Iipal/teethless40/README.md

# TeethLess40

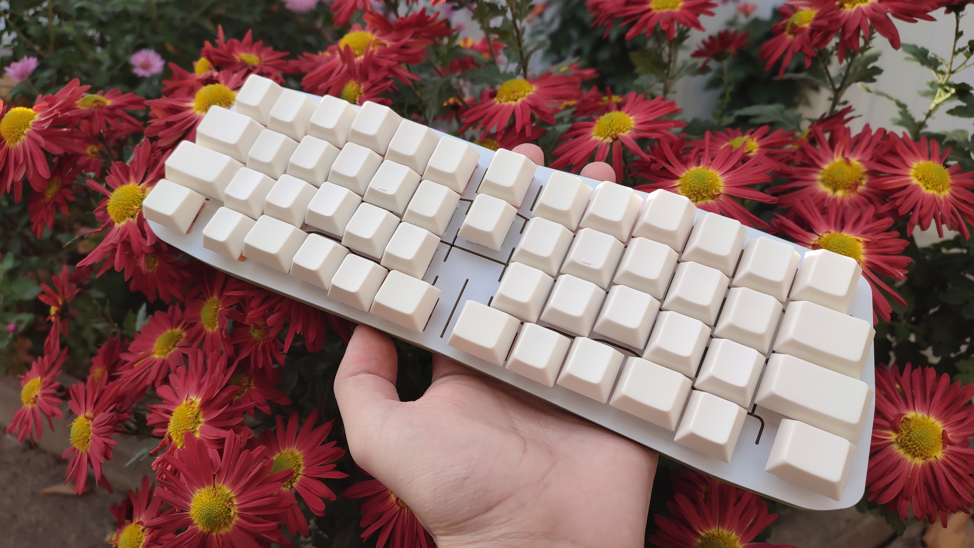
[picture p1: imgs/front.jpg]

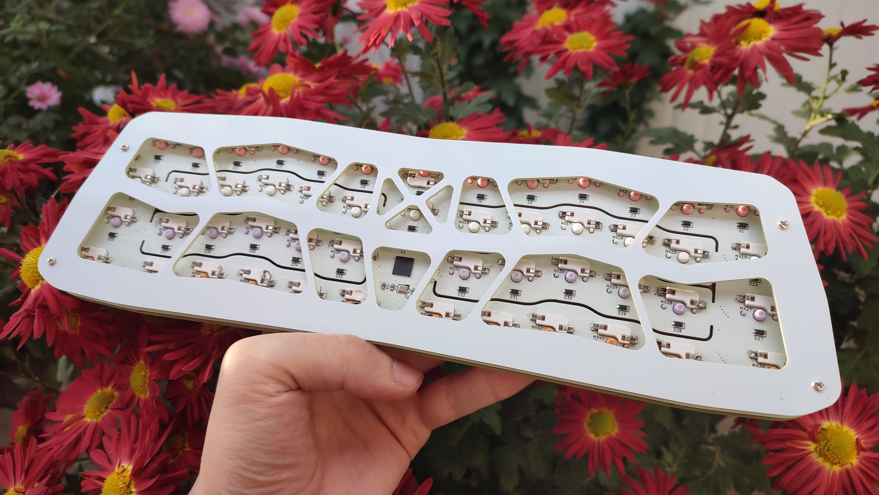
[picture p2: imgs/back.jpg]


# Layout

_40% Column-Staggered Symetrical Split-Layout_

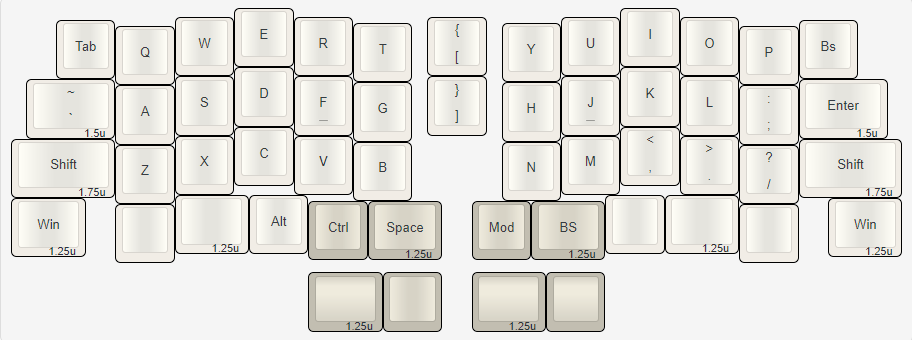
[picture p3: Layouts/imgs/v4.png]
