Iipal/teethless40/Cases/FR4/TL40_plateF_and_bottom.dxf

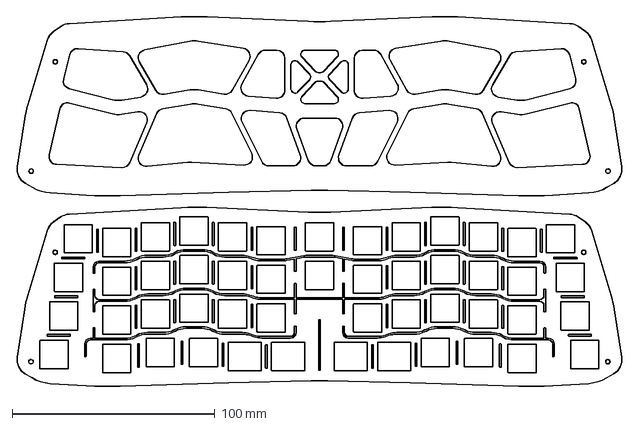
[picture p6: CAD file, 2022-11-02]
Cases/FR4/TL40_plateF_and_bottom.dxf
299.4 x 182.7 mm
