Iipal/teethless40/Cases/FR4/TL40_bottom.dxf

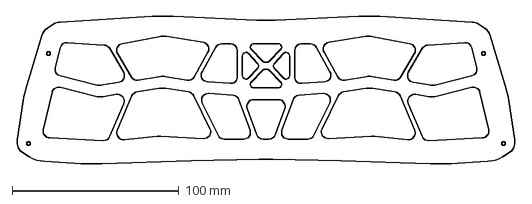
[picture p9: CAD file, 2022-11-02]
Cases/FR4/TL40_bottom.dxf
299.3 x 88.7 mm
