Iipal/teethless40/Cases/FR4/TL40_pcb.dxf

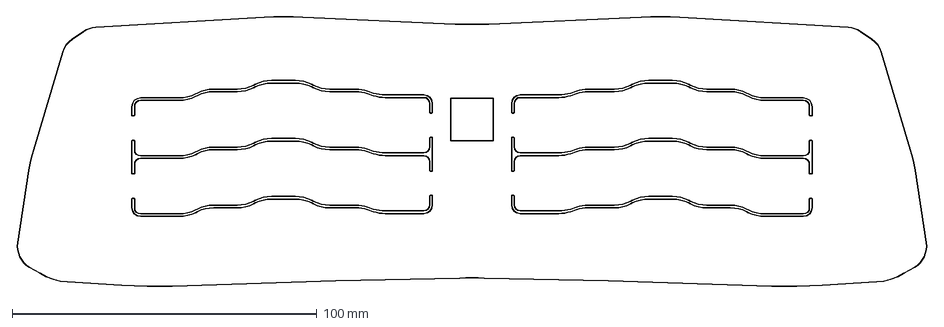
[picture p10: CAD file, 2022-11-02]
Cases/FR4/TL40_pcb.dxf
299.3 x 88.7 mm
