Iipal/teethless40/PCB/tl40_pcb.kicad_sch

## KiCad design PCB/tl40_pcb.kicad_sch (2022-11-02)

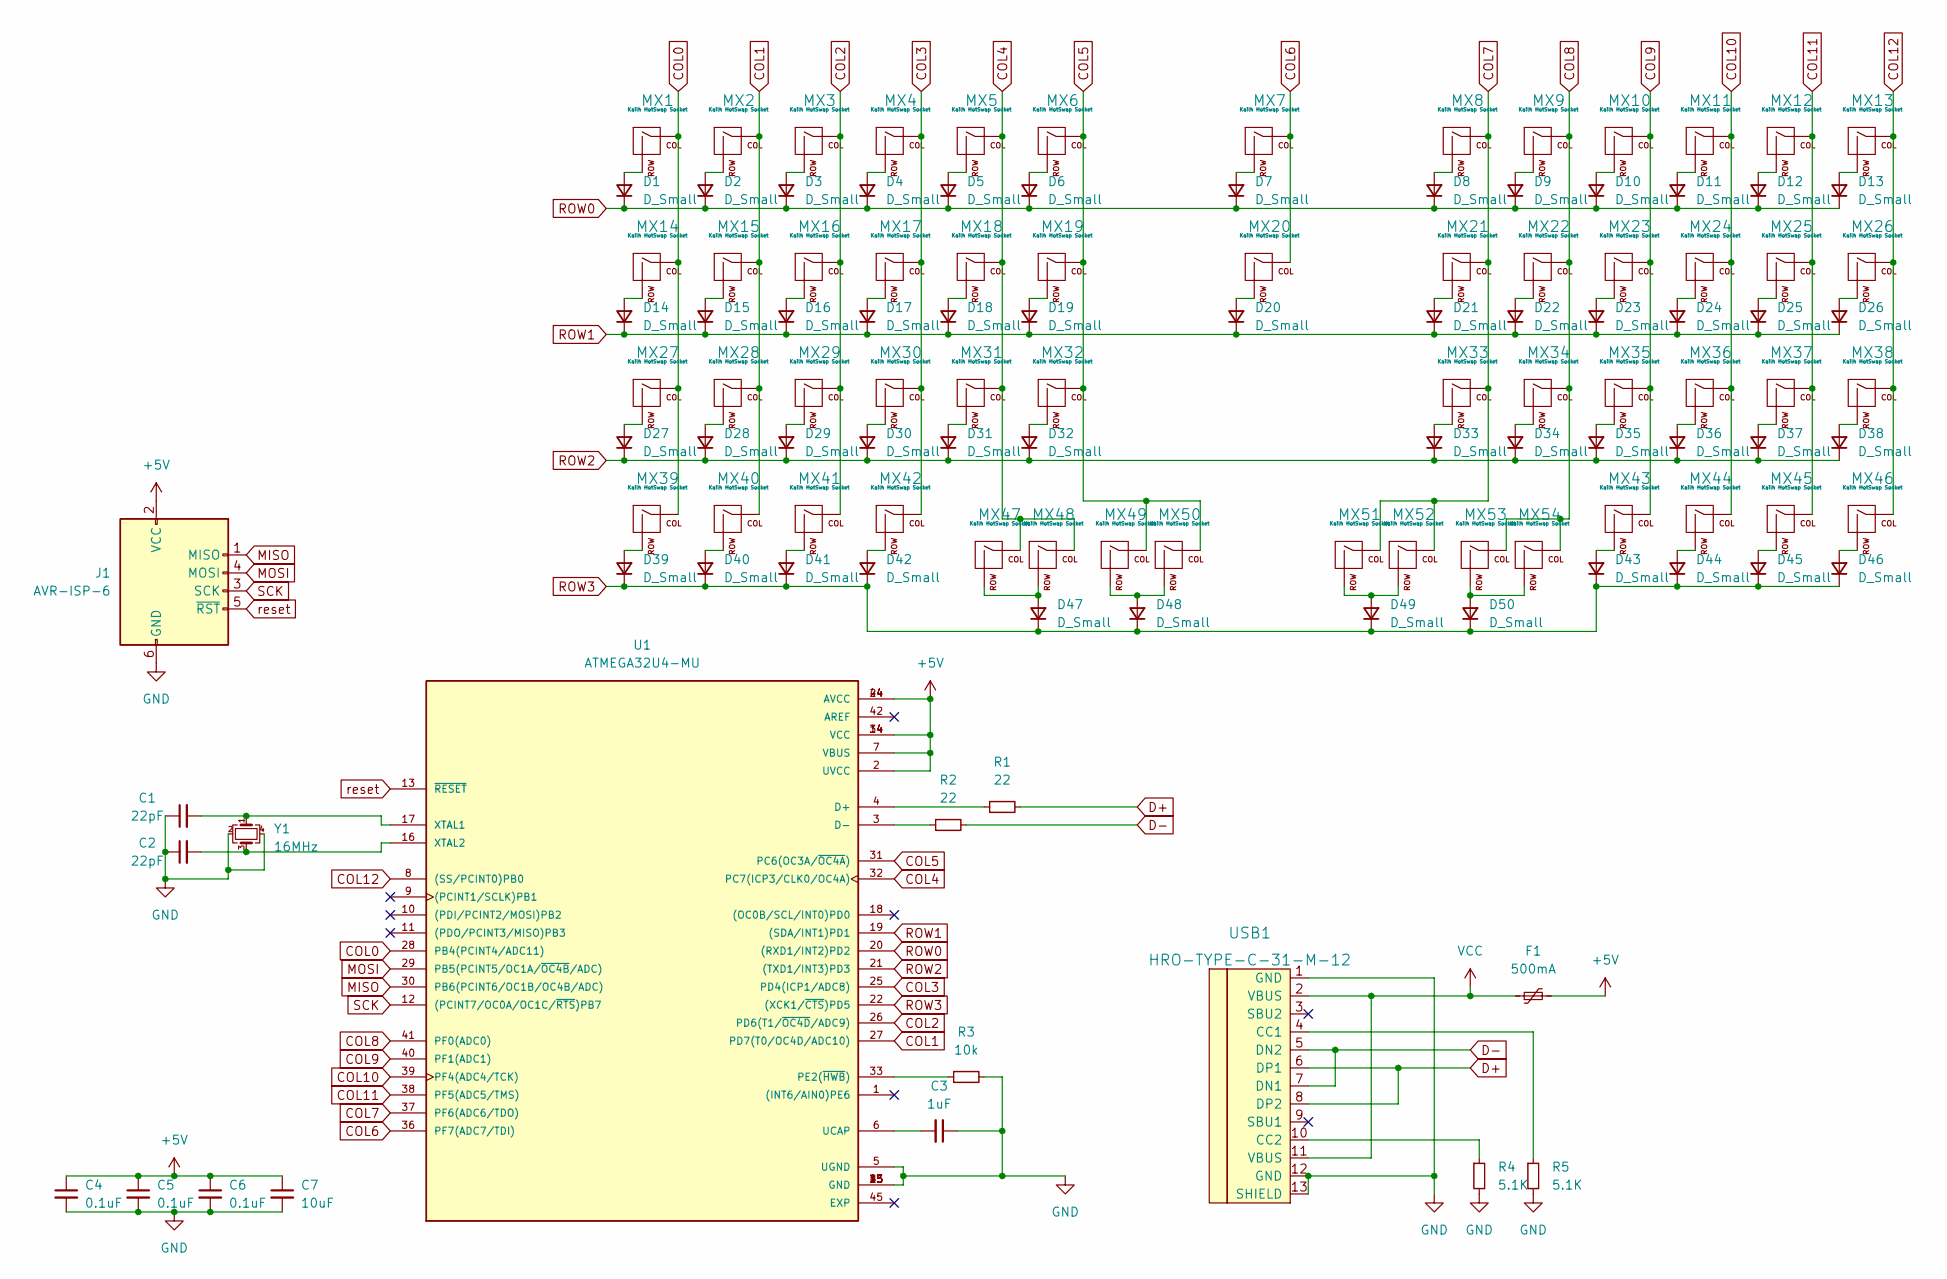
[picture p11: schematic tl40_pcb.kicad_sch]

Parts:
C1, C2: 22pF; C_0805_2012Metric; LCSC Part C472837
C3: 1uF; C_0805_2012Metric; LCSC Part C116352
C4, C5, C6: 0.1uF; C_0805_2012Metric; LCSC Part C38141
C7: 10uF; C_0805_2012Metric; LCSC Part C90545
D1, D2, D3, D4, D5, D6, D7, D8, D9, D10, D11, D12, D13, D14, D15, D16, D17, D18, D19, D20, D21, D22, D23, D24, D25, D26, D27, D28, D29, D30, D31, D32, D33, D34, D35, D36, D37, D38, D39, D40, D41, D42, D43, D44, D45, D46, D47, D48, D49, D50: D_Small; D_SOD-123; LCSC Part C77978
F1: 500mA; JK-nSMD050-24_F1206_; LCSC Part C369160
J1: AVR-ISP-6; AVR_ICSP_3x2; JLCPCB BOM False
MX1, MX2, MX3, MX4, MX5, MX6, MX7, MX8, MX9, MX10, MX11, MX12, MX13, MX15, MX16, MX17, MX18, MX19, MX20, MX21, MX22, MX23, MX24, MX25, MX28, MX29, MX30, MX31, MX32, MX33, MX34, MX35, MX36, MX37, MX40, MX42, MX43, MX45, MX47, MX50, MX51, MX54: Kailh HotSwap Socket; SW_MX_HS_1u; JLCPCB Part C5156480
MX14, MX26: Kailh HotSwap Socket; SW_MX_HS_1.5u; JLCPCB Part C5156480
MX27, MX38: Kailh HotSwap Socket; SW_MX_HS_1.75u; JLCPCB Part C5156480
MX39, MX41, MX44, MX46, MX48, MX49, MX52, MX53: Kailh HotSwap Socket; SW_MX_HS_1.25u; JLCPCB Part C5156480
R1, R2: 22; R_0805_2012Metric; LCSC Part C413152
R3: 10k; R_0805_2012Metric; LCSC Part C191101
R4, R5: 5.1K; R_0805_2012Metric; LCSC Part C413290
U1: ATMEGA32U4-MU; QFN50P700X700X100-45N; PARTREV E; LCSC Part C112161
USB1: HRO-TYPE-C-31-M-12; HRO-TYPE-C-31-M-12-Assembly; LCSC Part C165948
Y1: 16MHz; CRYSTAL-SMD_4P-L3.2-W2.5-BL; LCSC Part C258942

Connections:
+5V: C4.1, C5.1, C6.1, C7.1, F1.2, J1.2 (VCC), U1.2 (UVCC), U1.7 (VBUS), U1.14 (VCC), U1.24 (AVCC), U1.34 (VCC), U1.44 (AVCC)
COL0: MX1.1 (COL), MX14.1 (COL), MX27.1 (COL), MX39.1 (COL), U1.28 (PB4(PCINT4/ADC11))
COL1: MX2.1 (COL), MX15.1 (COL), MX28.1 (COL), MX40.1 (COL), U1.27 (PD7(T0/OC4D/ADC10))
COL2: MX3.1 (COL), MX16.1 (COL), MX29.1 (COL), MX41.1 (COL), U1.26 (PD6(T1/~OC4D/ADC9))
COL3: MX4.1 (COL), MX17.1 (COL), MX30.1 (COL), MX42.1 (COL), U1.25 (PD4(ICP1/ADC8))
COL4: MX5.1 (COL), MX18.1 (COL), MX31.1 (COL), MX47.1 (COL), MX48.1 (COL), U1.32 (PC7(ICP3/CLK0/OC4A))
COL5: MX6.1 (COL), MX19.1 (COL), MX32.1 (COL), MX49.1 (COL), MX50.1 (COL), U1.31 (PC6(OC3A/~OC4A))
COL6: MX7.1 (COL), MX20.1 (COL), U1.36 (PF7(ADC7/TDI))
COL7: MX8.1 (COL), MX21.1 (COL), MX33.1 (COL), MX51.1 (COL), MX52.1 (COL), U1.37 (PF6(ADC6/TDO))
COL8: MX9.1 (COL), MX22.1 (COL), MX34.1 (COL), MX53.1 (COL), MX54.1 (COL), U1.41 (PF0(ADC0))
COL9: MX10.1 (COL), MX23.1 (COL), MX35.1 (COL), MX43.1 (COL), U1.40 (PF1(ADC1))
COL10: MX11.1 (COL), MX24.1 (COL), MX36.1 (COL), MX44.1 (COL), U1.39 (PF4(ADC4/TCK))
COL11: MX12.1 (COL), MX25.1 (COL), MX37.1 (COL), MX45.1 (COL), U1.38 (PF5(ADC5/TMS))
COL12: MX13.1 (COL), MX26.1 (COL), MX38.1 (COL), MX46.1 (COL), U1.8 ((SS/PCINT0)PB0)
D+: R1.2, USB1.6 (DP1), USB1.8 (DP2)
D-: R2.2, USB1.5 (DN2), USB1.7 (DN1)
GND: C1.1, C2.1, C3.1, C4.2, C5.2, C6.2, C7.2, J1.6 (GND), R3.2, R4.2, R5.2, U1.5 (UGND), U1.15 (GND), U1.23 (GND), U1.35 (GND), U1.43 (GND), USB1.1 (GND), USB1.12 (GND), USB1.13 (SHIELD), Y1.2, Y1.4
MISO: J1.1 (MISO), U1.30 (PB6(PCINT6/OC1B/OC4B/ADC))
MOSI: J1.4 (MOSI), U1.29 (PB5(PCINT5/OC1A/~OC4B/ADC))
unnamed: C1.2, U1.17 (XTAL1), Y1.1
unnamed: C2.2, U1.16 (XTAL2), Y1.3
unnamed: C3.2, U1.6 (UCAP)
unnamed: D1.2 (A), MX1.2 (ROW)
unnamed: D2.2 (A), MX2.2 (ROW)
unnamed: D3.2 (A), MX3.2 (ROW)
unnamed: D4.2 (A), MX4.2 (ROW)
unnamed: D5.2 (A), MX5.2 (ROW)
unnamed: D6.2 (A), MX6.2 (ROW)
unnamed: D7.2 (A), MX7.2 (ROW)
unnamed: D8.2 (A), MX8.2 (ROW)
unnamed: D9.2 (A), MX9.2 (ROW)
unnamed: D10.2 (A), MX10.2 (ROW)
unnamed: D11.2 (A), MX11.2 (ROW)
unnamed: D12.2 (A), MX12.2 (ROW)
unnamed: D13.2 (A), MX13.2 (ROW)
unnamed: D14.2 (A), MX14.2 (ROW)
unnamed: D15.2 (A), MX15.2 (ROW)
unnamed: D16.2 (A), MX16.2 (ROW)
unnamed: D17.2 (A), MX17.2 (ROW)
unnamed: D18.2 (A), MX18.2 (ROW)
unnamed: D19.2 (A), MX19.2 (ROW)
unnamed: D20.2 (A), MX20.2 (ROW)
unnamed: D21.2 (A), MX21.2 (ROW)
unnamed: D22.2 (A), MX22.2 (ROW)
unnamed: D23.2 (A), MX23.2 (ROW)
unnamed: D24.2 (A), MX24.2 (ROW)
unnamed: D25.2 (A), MX25.2 (ROW)
unnamed: D26.2 (A), MX26.2 (ROW)
unnamed: D27.2 (A), MX27.2 (ROW)
unnamed: D28.2 (A), MX28.2 (ROW)
unnamed: D29.2 (A), MX29.2 (ROW)
unnamed: D30.2 (A), MX30.2 (ROW)
unnamed: D31.2 (A), MX31.2 (ROW)
unnamed: D32.2 (A), MX32.2 (ROW)
unnamed: D33.2 (A), MX33.2 (ROW)
unnamed: D34.2 (A), MX34.2 (ROW)
unnamed: D35.2 (A), MX35.2 (ROW)
unnamed: D36.2 (A), MX36.2 (ROW)
unnamed: D37.2 (A), MX37.2 (ROW)
unnamed: D38.2 (A), MX38.2 (ROW)
unnamed: D39.2 (A), MX39.2 (ROW)
unnamed: D40.2 (A), MX40.2 (ROW)
unnamed: D41.2 (A), MX41.2 (ROW)
unnamed: D42.2 (A), MX42.2 (ROW)
unnamed: D43.2 (A), MX43.2 (ROW)
unnamed: D44.2 (A), MX44.2 (ROW)
unnamed: D45.2 (A), MX45.2 (ROW)
unnamed: D46.2 (A), MX46.2 (ROW)
unnamed: D47.2 (A), MX47.2 (ROW), MX48.2 (ROW)
unnamed: D48.2 (A), MX49.2 (ROW), MX50.2 (ROW)
unnamed: D49.2 (A), MX51.2 (ROW), MX52.2 (ROW)
unnamed: D50.2 (A), MX53.2 (ROW), MX54.2 (ROW)
unnamed: R1.1, U1.4 (D+)
unnamed: R2.1, U1.3 (D-)
unnamed: R3.1, U1.33 (PE2(~HWB))
unnamed: R4.1, USB1.10 (CC2)
unnamed: R5.1, USB1.4 (CC1)
ROW0: D1.1 (K), D2.1 (K), D3.1 (K), D4.1 (K), D5.1 (K), D6.1 (K), D7.1 (K), D8.1 (K), D9.1 (K), D10.1 (K), D11.1 (K), D12.1 (K), D13.1 (K), U1.20 ((RXD1/INT2)PD2)
ROW1: D14.1 (K), D15.1 (K), D16.1 (K), D17.1 (K), D18.1 (K), D19.1 (K), D20.1 (K), D21.1 (K), D22.1 (K), D23.1 (K), D24.1 (K), D25.1 (K), D26.1 (K), U1.19 ((SDA/INT1)PD1)
ROW2: D27.1 (K), D28.1 (K), D29.1 (K), D30.1 (K), D31.1 (K), D32.1 (K), D33.1 (K), D34.1 (K), D35.1 (K), D36.1 (K), D37.1 (K), D38.1 (K), U1.21 ((TXD1/INT3)PD3)
ROW3: D39.1 (K), D40.1 (K), D41.1 (K), D42.1 (K), D43.1 (K), D44.1 (K), D45.1 (K), D46.1 (K), D47.1 (K), D48.1 (K), D49.1 (K), D50.1 (K), U1.22 ((XCK1/~CTS)PD5)
SCK: J1.3 (SCK), U1.12 ((PCINT7/OC0A/OC1C/~RTS)PB7)
VCC: F1.1, USB1.2 (VBUS), USB1.11 (VBUS)
reset: J1.5 (~RST), U1.13 (~RESET)
